MuhammadMohtashim/Infusionpump/Electronics/Pictures/fig1.jpg

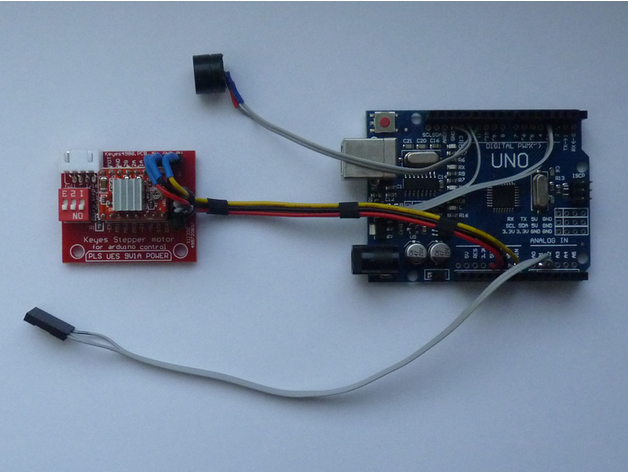
Electronics/Pictures/fig1.jpg
