MuhammadMohtashim/Infusionpump/Electronics/Pictures/fig2.jpg

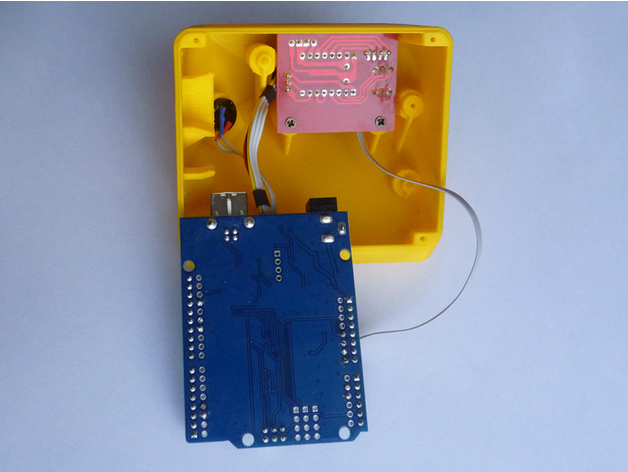
Electronics/Pictures/fig2.jpg
