MuhammadMohtashim/Infusionpump/README.md

# Infusion Pump
An infusion Pump I created by sourcing many online sources. I wanted to create an Infusion pump that would be based on an Arduino, was user friendly and easy to create at home.  

The first source I used was Karpova's Syringe Pump. I have tweaked the original laser cut design to make it more robust and stable. The original design had only one guding rod. This made it very unstable in my testing and oeprations. Ergo, I added another guiding rod to make it more stable. The link to the original repo is given below.

https://github.com/Karpova-Lab/syringe-pump/tree/lasercut_frame

But Karapova's pump is STM based and I wanted an Arduino based system so I used code, electronics and the controller case from Mass Spectrometry Laboratory of Moscow State University.

http://www.mass-spec.ru/projects/diy/syringe_pump/eng/

# Janelia Open-Source Hardware
By downloading, using and/or viewing these designs, documentation and related data and information, and all content in the foregoing (collectively, the “Designs”), you agree to the following:

You may use, copy, modify, display and distribute the Designs for any non-commercial research or educational purpose.

THE DESIGNS ARE PROTOTYPES AND ARE EXPERIMENTAL IN NATURE AND SHOULD BE USED WITH PRUDENCE AND APPROPRIATE CAUTION, AS NOT ALL OF THE CHARACTERISTICS ARE KNOWN. THE DESIGNS ARE PROVIDED “AS-IS” WITHOUT ANY EXPRESS OR IMPLIED WARRANTIES OF ANY KIND (INCLUDING, BUT NOT LIMITED TO, ANY IMPLIED WARRANTIES OF MERCHANTABILITY, NON-INFRINGEMENT, TITLE, ACCURACY, OR FITNESS FOR A PARTICULAR PURPOSE, AND ANY WARRANTIES ARISING FROM COURSE OF PERFORMANCE, COURSE OF DEALING, COURSE OF CONDUCT, OR USAGE OF TRADE) OR CONDITIONS OF ANY KIND, WHETHER EXPRESS OR IMPLIED OR STATUTORY. NO OPINION, ADVICE OR STATEMENT OF THE HOWARD HUGHES MEDICAL INSTITUTE (“HHMI”) OR ITS TRUSTEES, EMPLOYEES, AGENTS, LICENSORS OR SUPPLIERS, WHETHER MADE WITHIN THE DESIGNS OR OTHERWISE, SHALL CREATE ANY WARRANTY. HHMI MAKES NO WARRANTY THAT THE DESIGNS WILL BE ACCURATE, CURRENT OR RELIABLE. SOME JURISDICTIONS DO NOT ALLOW THE EXCLUSION OF CERTAIN WARRANTIES OR CONDITIONS, AND AS A CONSEQUENCE SOME OF THE ABOVE DISCLAIMERS MAY NOT APPLY TO YOU. 

IN NO EVENT SHALL HHMI OR ITS TRUSTEES, EMPLOYEES, AGENTS, LICENSORS OR SUPPLIERS (THE “HHMI PARTIES”) BE LIABLE FOR ANY DIRECT, INDIRECT, INCIDENTAL, SPECIAL, EXEMPLARY, CONSEQUENTIAL, OR PUNITIVE DAMAGES OR LOSSES OF ANY KIND (INCLUDING, BUT NOT LIMITED TO, ANY PROCUREMENT OF SUBSTITUTE GOODS OR SERVICES; LOSS OF USE, BUSINESS, GOODWILL, DATA, REVENUE, OR PROFITS; REASONABLE ROYALTIES; BUSINESS INTERRUPTION; OR OTHER INTANGIBLE LOSSES) HOWEVER CAUSED AND ON ANY THEORY OF LIABILITY, WHETHER IN CONTRACT, STRICT LIABILITY, TORT (INCLUDING, WITHOUT LIMITATION, NEGLIGENCE) OR OTHERWISE, ARISING IN ANY WAY OUT OF THE USE OF, OR INABILITY TO USE, THE DESIGNS, OR FOR ANY OTHER CLAIM RELATED IN ANY WAY TO YOUR USE OF THE DESIGNS OR YOUR INTERACTIONS WITH HHMI, EVEN IF ADVISED OF THE POSSIBILITY OF SUCH DAMAGE OR LOSS, AND NOTWITHSTANDING THE FAILURE OF ESSENTIAL PURPOSE OF ANY LIMITED REMEDY. YOU ACKNOWLEDGE THAT THESE LIMITATIONS ARE REASONABLE, THAT THEY ARE AN ESSENTIAL ELEMENT HEREOF, AND THAT ABSENT SUCH LIMITATIONS, HHMI WOULD NOT MAKE THE DESIGNS AVAILABLE TO YOU OR ENTER INTO THESE TERMS AND CONDITIONS. YOU REMAIN RESPONSIBLE FOR ALL LEGAL COMPLIANCE WITH RESPECT TO YOUR USAGE OF THE DESIGNS. SOME JURISDICTIONS DO NOT ALLOW THE LIMITATION OF LIABILITY FOR INCIDENTAL OR CONSEQUENTIAL DAMAGES, AND AS A CONSEQUENCE SOME OF THE ABOVE LIMITATIONS MAY NOT APPLY TO YOU; IN SUCH JURISDICTIONS, THE LIABILITY OF THE HHMI PARTIES SHALL BE LIMITED TO THE FULLEST EXTENT PERMITTED BY LAW.

Any redistribution of the Designs must contain or reference these terms.

# Janelia Open-Source Software

Redistribution and use in source and binary forms, with or without modification, are permitted provided that the following conditions are met:

Redistributions of source code must retain the above copyright notice, this list of conditions and the following disclaimer.
Redistributions in binary form must reproduce the above copyright notice, this list of conditions and the following disclaimer in the documentation and/or other materials provided with the distribution.
Neither the name of HHMI nor the names of its contributors may be used to endorse or promote products derived from this software without specific prior written permission.
THIS SOFTWARE IS PROVIDED BY THE COPYRIGHT HOLDERS AND CONTRIBUTORS “AS IS” AND ANY EXPRESS OR IMPLIED WARRANTIES, INCLUDING, BUT NOT LIMITED TO, THE IMPLIED WARRANTIES OF MERCHANTABILITY AND FITNESS FOR A PARTICULAR PURPOSE ARE DISCLAIMED. IN NO EVENT SHALL THE COPYRIGHT OWNER OR CONTRIBUTORS BE LIABLE FOR ANY DIRECT, INDIRECT, INCIDENTAL, SPECIAL, EXEMPLARY, OR CONSEQUENTIAL DAMAGES (INCLUDING, BUT NOT LIMITED TO, PROCUREMENT OF SUBSTITUTE GOODS OR SERVICES; LOSS OF USE, DATA, OR PROFITS; OR BUSINESS INTERRUPTION) HOWEVER CAUSED AND ON ANY THEORY OF LIABILITY, WHETHER IN CONTRACT, STRICT LIABILITY, OR TORT (INCLUDING NEGLIGENCE OR OTHERWISE) ARISING IN ANY WAY OUT OF THE USE OF THIS SOFTWARE, EVEN IF ADVISED OF THE POSSIBILITY OF SUCH DAMAGE.
