MuhammadMohtashim/Infusionpump/Electronics/README.md

# Note before Starting

The original files are available on the website 

http://www.mass-spec.ru/projects/diy/syringe_pump/eng/

However, the stl files for the case and the assembly pictures are provided for easier understanding. 
Also, for the assembly of electronics the Assembly Instructions.pdf is provided along with the Arduino Code.
