MuhammadMohtashim/Infusionpump/Laser Cut Files/README.md

# Note before Starting

For assembly instructions and the BOM for the body of the syringe pump, you can view the original guide to assembly.

https://karpova-lab.github.io/syringe-pump/frame.html#assembly

The only difference is that you are going to use my plunegr instead of the original. And from the BOm you will buy two guiding rod instead of one.
