MuhammadMohtashim/Infusionpump/Electronics/Pictures/case1.jpg

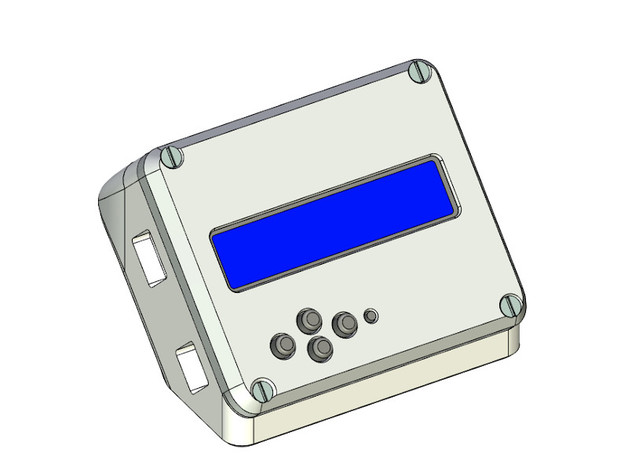
Electronics/Pictures/case1.jpg
