MuhammadMohtashim/Infusionpump/Electronics/Pictures/case2.jpg

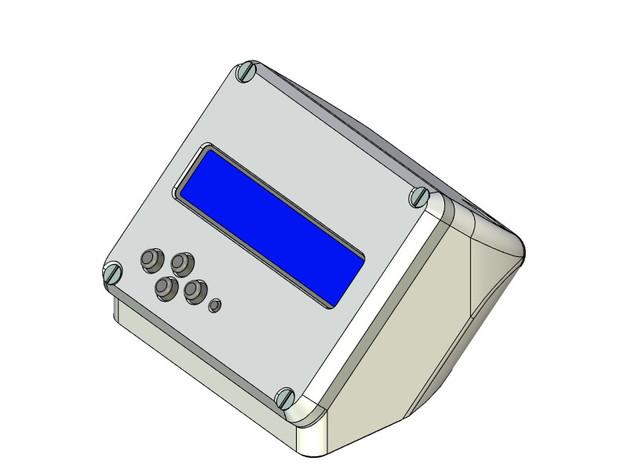
Electronics/Pictures/case2.jpg
