MuhammadMohtashim/Infusionpump/Electronics/Pictures/fig3.jpg

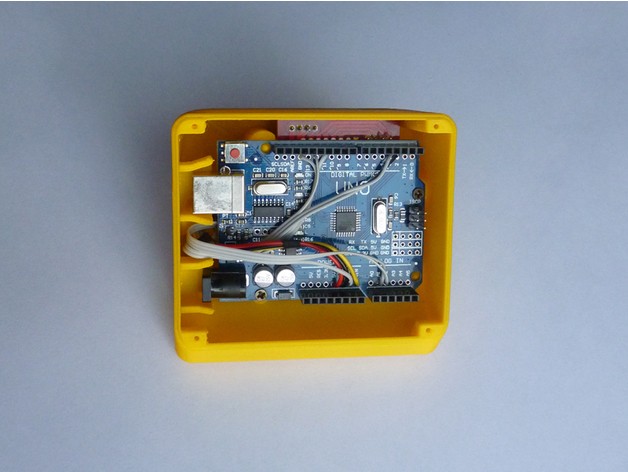
Electronics/Pictures/fig3.jpg
