MuhammadMohtashim/Infusionpump/Electronics/Pictures/fig4.jpg

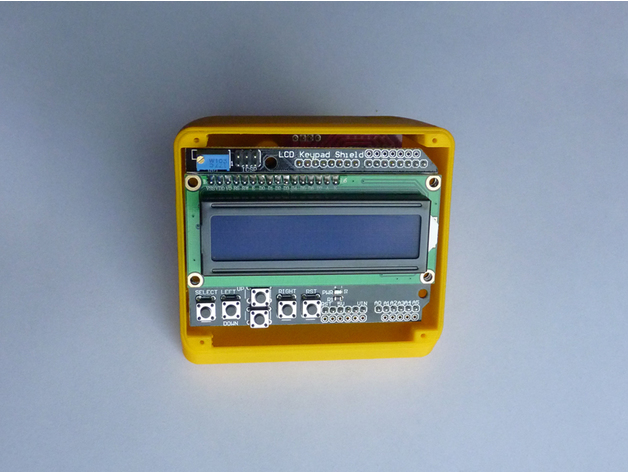
Electronics/Pictures/fig4.jpg
