MuhammadMohtashim/Infusionpump/Electronics/Pictures/fig5.jpg

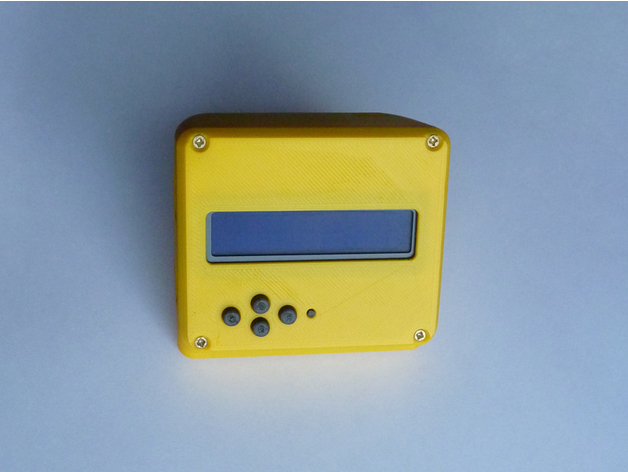
Electronics/Pictures/fig5.jpg
