MuhammadMohtashim/Infusionpump/Electronics/STL files for Case/caseButtons.stl

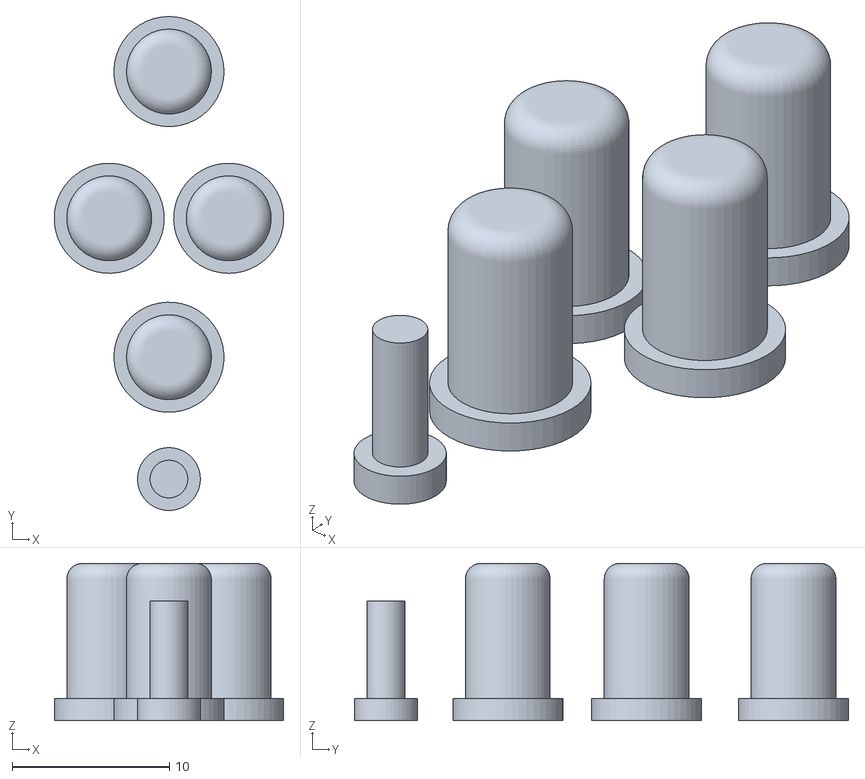
[picture p8: CAD file, 2021-05-01]
Electronics/STL files for Case/caseButtons.stl
14.6 x 31.4 x 10.0
