MuhammadMohtashim/Infusionpump/Electronics/STL files for Case/caseСover.stl

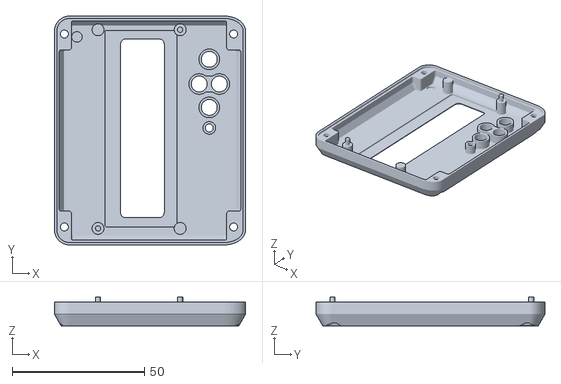
[picture p9: CAD file, 2021-05-01]
Electronics/STL files for Case/caseСover.stl
72.2 x 86.5 x 10.9
