MuhammadMohtashim/Infusionpump/Electronics/STL files for Case/caseBase.stl

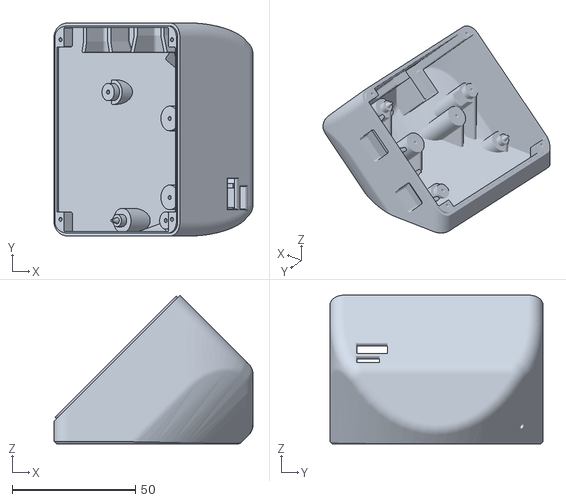
[picture p10: CAD file, 2021-05-01]
Electronics/STL files for Case/caseBase.stl
80.7 x 86.5 x 60.3
